h-milz/wireless-gk/doc/Filter-NE5532.png

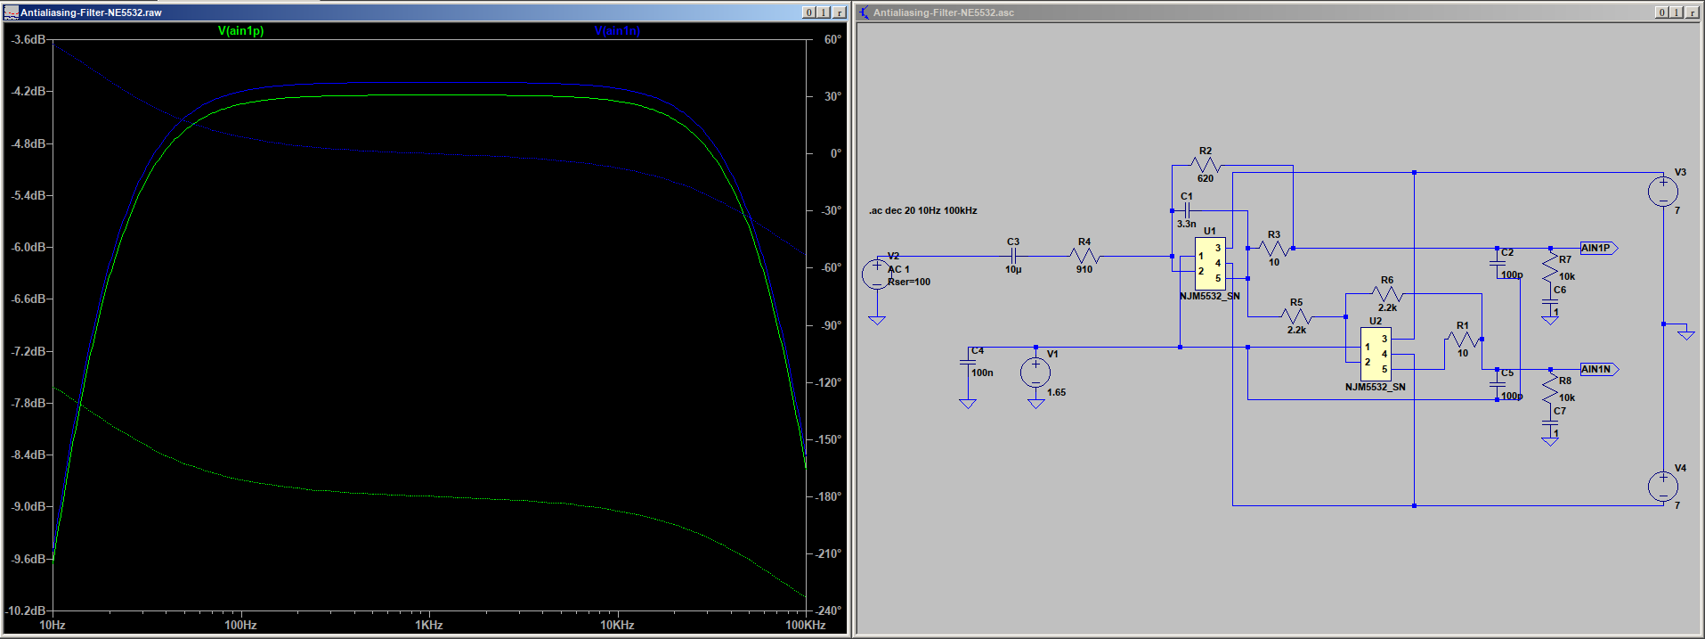
doc/Filter-NE5532.png
