h-milz/wireless-gk/doc/GK-3-schematics.png

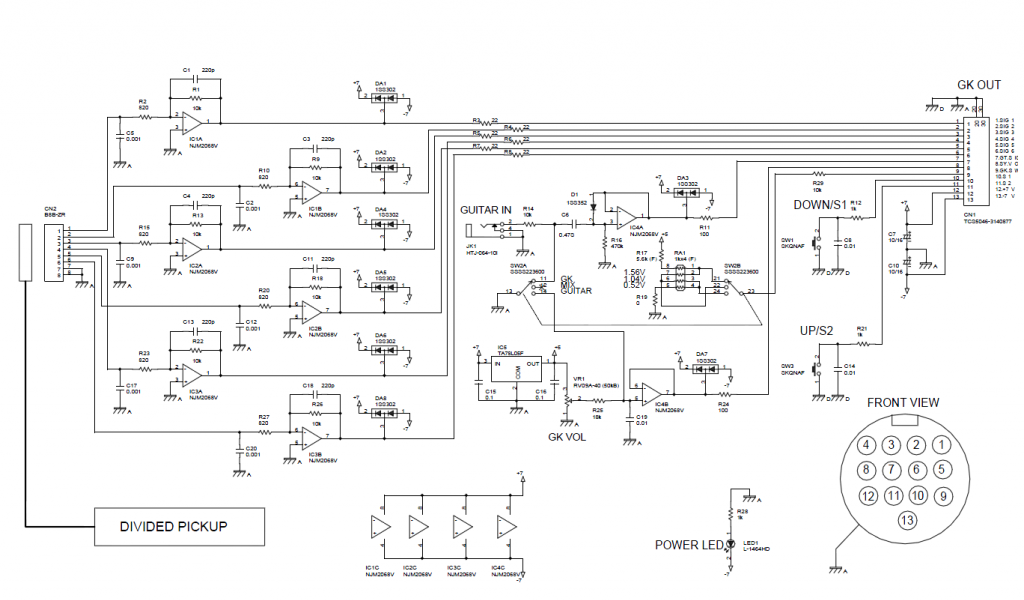
doc/GK-3-schematics.png
