h-milz/wireless-gk/main/main.c

/* 
    Copyright (C) 2024 Harald Milz <hm@seneca.muc.de> 

    This file is part of Wireless-GK.
    
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
    You should have received a copy of the GNU General Public License
    along with Wireless-GK.  If not, see <http://www.gnu.org/licenses/>.
*/

#include "wireless_gk.h"

#define ID_PIN                  GPIO_NUM_13             // take the one that is nearest to GND

static const char *TAG = "wgk_main";

EventGroupHandle_t s_wifi_event_group;

// static volatile uint32_t sample_count = 0; // , txcount = 0, rxcount = 0, losses = 0, loopcount = 0, overall_losses = 0, overall_packets = 0;

udp_buf_t *udp_tx_buf, *udp_rx_buf;

#if (defined RX_DEBUG || defined TX_DEBUG)
DRAM_ATTR volatile int p = 0; 
DRAM_ATTR volatile log_t _log[NUM];   
#endif 

// uint32_t time1; 

#ifdef WITH_TEMP
float rx_temp, tx_temp;
#endif


// Timer configuration
#include "driver/gptimer.h"

// Handle for the general-purpose timer
static gptimer_handle_t gptimer = NULL;

// Initialize the hardware timer
static void init_hardware_timer(void) {
    gptimer_config_t timer_config = {
        .clk_src = GPTIMER_CLK_SRC_DEFAULT, // Use default clock source
        .direction = GPTIMER_COUNT_UP,     // Count upwards
        .resolution_hz = 1000000,          // 1 MHz resolution (1 tick = 1 µs)
    };
    ESP_ERROR_CHECK(gptimer_new_timer(&timer_config, &gptimer));
    ESP_ERROR_CHECK(gptimer_enable(gptimer));
    ESP_ERROR_CHECK(gptimer_start(gptimer));
}

// ISR-safe function to read the timer value
uint32_t get_time_us_in_isr(void) {
    uint64_t timer_val = 0;
    ESP_ERROR_CHECK(gptimer_get_raw_count(gptimer, &timer_val));
    return (uint32_t) timer_val & 0xffffffff;
}


/*
 * WiFi stuff
 */

// mostly copied from examples/wifi/getting_started/station/main/station_example_main.c
/* FreeRTOS event group to signal when we are connected*/
static int s_retry_num = 0;



void monitor_task(void *args) {
    UBaseType_t hwm; 
    char *task_name; 
    bool *sender = (bool *) args;
    TaskHandle_t tasks[] = { i2s_rx_task_handle, udp_tx_task_handle, i2s_tx_task_handle, udp_rx_task_handle, NULL };
    while (1) {
        for (int i=0; i<sizeof(tasks)/sizeof(TaskHandle_t); i++) {
            hwm = uxTaskGetStackHighWaterMark(tasks[i]);
            task_name = pcTaskGetName(tasks[i]);
            ESP_LOGI (TAG, "task %s, HWM %d", task_name, hwm);
        }
        ESP_LOGI (TAG, "largest free block: %u", heap_caps_get_largest_free_block(MALLOC_CAP_8BIT));
        ESP_LOGI (TAG, "min free heap size: %lu", esp_get_minimum_free_heap_size());

        vTaskDelay (1000/portTICK_PERIOD_MS);
    }
}

#ifdef WITH_TEMP    
#include "driver/temperature_sensor.h"
void tx_temp_task(void *args) {
    temperature_sensor_handle_t temp_sensor = NULL;
    temperature_sensor_config_t temp_sensor_config = TEMPERATURE_SENSOR_CONFIG_DEFAULT(10, 80);

    temperature_sensor_install(&temp_sensor_config, &temp_sensor);
    ESP_LOGI(TAG, "Enable temperature sensor");
    temperature_sensor_enable(temp_sensor);

    while (1) {
        temperature_sensor_get_celsius(temp_sensor, &tx_temp);
        ESP_LOGI(TAG, "T = %.1f °C", tx_temp); 
        vTaskDelay (10000/portTICK_PERIOD_MS);  // once per minute
    }
}

void rx_temp_task(void *args) {
    temperature_sensor_handle_t temp_sensor = NULL;
    temperature_sensor_config_t temp_sensor_config = TEMPERATURE_SENSOR_CONFIG_DEFAULT(10, 80);

    temperature_sensor_install(&temp_sensor_config, &temp_sensor);
    ESP_LOGI(TAG, "Enable temperature sensor");
    temperature_sensor_enable(temp_sensor);

    while (1) {
        temperature_sensor_get_celsius(temp_sensor, &rx_temp);
        // ESP_LOGI(TAG, "T = %.1f °C", temperature); 
        vTaskDelay (10000/portTICK_PERIOD_MS);  // once per minute
    }
}
#endif


// calculate simple XOR checksum based on uint32_t, which is much faster than using uint8_t
// there are 4x less XOR operations
// and ESP32 does not support unaligned uint8_t accesses and will always generate an exception
uint32_t calculate_checksum(uint32_t *buffer, size_t size) {
    uint32_t checksum = 0;
    int i; 
    
    for (i = 0; i < size; i++) {  
        checksum ^= *(buffer + i);
    }
    return checksum; 
}



void app_main(void) {

    bool sender = false; 
    bool creds_available = false;
    bool setup_requested = false;
    int i; 
    
    //Initialize NVS
    esp_err_t ret = nvs_flash_init();
    if (ret == ESP_ERR_NVS_NO_FREE_PAGES || ret == ESP_ERR_NVS_NEW_VERSION_FOUND) {
      ESP_ERROR_CHECK(nvs_flash_erase());
      ret = nvs_flash_init();
      ESP_LOGW(TAG, "nvs erase, init"); 
    }
    ESP_ERROR_CHECK(ret);
    s_wifi_event_group = xEventGroupCreate();
    
    // check if we're sender or receiver. The sender has ID_PIN = 0
    gpio_reset_pin(ID_PIN);
    gpio_set_direction(ID_PIN, GPIO_MODE_INPUT);
    gpio_set_pull_mode(ID_PIN, GPIO_PULLUP_ONLY);
    gpio_pullup_en(ID_PIN);
    if (gpio_get_level(ID_PIN) == 0) {
        sender = true; 
    } 
    gpio_reset_pin(ID_PIN);

    init_hardware_timer();
    
    if (sender) {
        // initialize GPIO pins
        // returns true if setup was pressed
        setup_requested = init_gpio_tx();
        if (setup_requested) {   // setup needed
            ESP_ERROR_CHECK(nvs_flash_erase());
            nvs_flash_init();
            ESP_LOGI(TAG, "setup requested, entering setup mode");
        }
    
        // initialize Wifi STA
        init_wifi_tx(setup_requested);
        
        // let it settle. 
        vTaskDelay(200/portTICK_PERIOD_MS);

#ifdef WITH_TEMP    
        xTaskCreate(tx_temp_task, "tx_temp_task", 4096, NULL, 5, NULL);
#endif
        
        // create udp send buffer explicitly in RAM
        udp_tx_buf = (udp_buf_t *)heap_caps_calloc(1, sizeof(udp_buf_t), MALLOC_CAP_8BIT | MALLOC_CAP_INTERNAL);         
        
        // set up I2S receive channel on the Sender
        i2s_new_channel(&i2s_rx_chan_cfg, NULL, &i2s_rx_handle);
        // this will later be i2s_channel_init_tdm_mode(). 
#ifdef I2S_STD
        i2s_channel_init_std_mode(i2s_rx_handle, &i2s_rx_cfg);
#else
        i2s_channel_init_tdm_mode(i2s_rx_handle, &i2s_rx_cfg);
#endif        

// #ifdef LATENCY_MEAS            
        // xTaskCreate(latency_meas_task, "latency_meas_task", 4096, NULL, 5, NULL);
// #else        
        // create I2S Rx task
        // xTaskCreate(i2s_rx_task, "i2s_rx_task", 4096, NULL, 18, &i2s_rx_task_handle);

        // create UDP Tx task
        xTaskCreate(udp_tx_task, "udp_tx_task", 4096, NULL, 18, &udp_tx_task_handle);

        // xTaskCreate(monitor_task, "monitor_task", 4096, &sender, 3, NULL);

        // create I2S rx on_recv callback
        i2s_event_callbacks_t cbs = {
            .on_recv = i2s_rx_callback,
            .on_recv_q_ovf = NULL,
            .on_sent = NULL,
            .on_send_q_ovf = NULL,
        };
        i2s_channel_register_event_callback(i2s_rx_handle, &cbs, NULL);

        // enable channel
        i2s_channel_enable(i2s_rx_handle);
// #endif /* LATENCY_MEAS*/        
        // ESP_LOGI(TAG, "sizeof(udp_tx_buf) = %d", sizeof(udp_buf_t));
        
    } else {   // receiver
        // initialize GPIO pins
        // returns true if setup was pressed
        setup_requested = init_gpio_rx();
        if (setup_requested) {   // setup needed
            ESP_ERROR_CHECK(nvs_flash_erase());
            nvs_flash_init();
            ESP_LOGI(TAG, "setup requested, entering setup mode");
        }

        // TODO check if we had WiFi credentials in NVS, if not, setup. 
    
        // initialize Wifi AP
        init_wifi_rx(setup_requested);
        // let it settle. 
        vTaskDelay(200/portTICK_PERIOD_MS);
        
#ifdef WITH_TEMP    
        xTaskCreate(rx_temp_task, "rx_temp_task", 4096, NULL, 5, NULL);
#endif

        // initialize i2s ring buffer
        if (!ring_buf_init()) {              // This Should Not Happen[TM]
            vTaskDelete(NULL); 
        }
        // and the UDP receive buffer
        udp_rx_buf = (udp_buf_t *)heap_caps_calloc(1, sizeof(udp_buf_t), MALLOC_CAP_8BIT | MALLOC_CAP_INTERNAL); 
            
        // set up I2S send channel on the Receiver
        i2s_new_channel(&i2s_tx_chan_cfg, &i2s_tx_handle, NULL);
        // this will later be i2s_channel_init_tdm_mode(). 
#ifdef I2S_STD
        i2s_channel_init_std_mode(i2s_tx_handle, &i2s_tx_cfg);
#else
        i2s_channel_init_tdm_mode(i2s_tx_handle, &i2s_tx_cfg);
#endif               

        // create UDP Rx task
        xTaskCreate(udp_rx_task, "udp_rx_task", 4096, NULL, 18, &udp_rx_task_handle);
        
#ifdef RX_STATS
        xTaskCreate(rx_stats_task, "rx_stats_task", 4096, NULL, 5, NULL); 
#endif        

        // xTaskCreate(monitor_task, "monitor_task", 4096, NULL, 3, NULL);

        // create I2S tx on_sent callback
        i2s_event_callbacks_t cbs = {
            .on_recv = NULL,
            .on_recv_q_ovf = NULL,
            .on_sent = i2s_tx_callback,
            .on_send_q_ovf = NULL,
        };
        i2s_channel_register_event_callback(i2s_tx_handle, &cbs, NULL);

        i2s_channel_enable(i2s_tx_handle);
        // time1 = get_time_us_in_isr();
        // stats[0] = -1000;
        // stats[1] = 1000; 
        // ESP_LOGI(TAG, "sizeof(udp_rx_buf) = %d", sizeof(udp_buf_t));
        // ESP_LOGI(TAG, "sizeof(ringbuf)    = %d", ring_buf_size());
    }
    
    ESP_LOGI (TAG, "largest free block: %u", heap_caps_get_largest_free_block(MALLOC_CAP_8BIT));
    ESP_LOGI (TAG, "min free heap size: %lu", esp_get_minimum_free_heap_size());

/*    
    while (1) {
        vTaskDelay(1000/ portTICK_PERIOD_MS);
    }
*/    
}
