h-milz/wireless-gk/main/wireless_gk.h

/* 
    Copyright (C) 2024 Harald Milz <hm@seneca.muc.de> 

    This file is part of Wireless-GK.
    
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
    You should have received a copy of the GNU General Public License
    along with Wireless-GK.  If not, see <http://www.gnu.org/licenses/>.
*/

#ifndef _WIRELESS_GK_H
#define _WIRELESS_GK_H

#include <string.h>
#include <stdlib.h>
#include <stdio.h> 
#include <dirent.h> 
#include "freertos/FreeRTOS.h"
#include "freertos/event_groups.h"
#include "freertos/queue.h"
#include "freertos/task.h"
#include "esp_event.h"
#include "esp_heap_caps.h"
#include "esp_log.h"
#include "esp_netif.h"
#include "esp_random.h"
#include "esp_system.h"
#include "esp_timer.h"
#include "esp_wifi.h"
#include "esp_wps.h"
#include "nvs_flash.h"
#include "driver/gpio.h"
#include "rom/ets_sys.h"
#include "lwip/err.h"
#include <lwip/netdb.h>
#include "lwip/sockets.h"
#include "lwip/sys.h"
#include "lwip/errno.h"
// #include "ringbuf.h" 


// TODO remove for production compilation 
#pragma GCC diagnostic ignored "-Wunused-variable"
#pragma GCC diagnostic ignored "-Wunused-but-set-variable"


// #define TX_DEBUG
// #define RX_DEBUG
// #define LATENCY_MEAS                 // activate this if you want to do a UDP latency measurement. 
                                        // Connect Tx SIG_PIN to Rx ISR_PIN and GND to GND. 
#define WITH_TEMP

// during development, we use STD with PCM1808 ADC and PCM5102 DAC
#define I2S_STD
// #define I2S_TDM

#ifdef I2S_STD
#include "driver/i2s_std.h"
#else
#include "driver/i2s_tdm.h"
#endif

/* ***************************************************************
 * WiFi Defines
 * ***************************************************************/

#define TX_TEST

#ifdef TX_TEST
#define SSID "WGK"
#define PASS "start123"
#define WIFI_CHANNEL 144
#endif
#define RX_IP_ADDR "192.168.4.1"
#define PORT 45678

#define MAX_RETRY 5

#define WIFI_CONNECTED_BIT BIT0
#define WIFI_FAIL_BIT      BIT1

extern EventGroupHandle_t s_wifi_event_group;
void event_handler(void* arg, esp_event_base_t event_base, int32_t event_id, void* event_data);


/* ***************************************************************
 * Logging
 * ***************************************************************/

#if (defined RX_DEBUG || defined TX_DEBUG)
#define NUM 50
typedef struct { 
    uint8_t loc;        // location
    uint32_t time;      // timestamp in µs
    uint8_t *ptr;       // pointer to buffer
    uint32_t size;        // data size
    uint32_t uint32ptr;       // converted pointer to buffer
} log_t; 
extern volatile int p;
extern volatile log_t _log[];
#endif 

/* ***************************************************************
 * I2S Defines
 * ***************************************************************/

#define I2S_MCLK_MULTIPLE I2S_MCLK_MULTIPLE_256
#define I2S_DATA_BIT_WIDTH I2S_DATA_BIT_WIDTH_32BIT

/*
 * Definitions for I2S
 * SAMPLE  is a single sample for one channel (32 bit data block containing a 16, 24, or 32 bit ADC sample)
 * FRAME   is a collection of NUM_SLOTS slots (mono samples per channel)
 *         see MSB format in 
 *         https://docs.espressif.com/projects/esp-idf/en/latest/esp32c5/api-reference/peripherals/i2s.html#tdm-mode
 * NFRAMES is the number of frames we want to send in one datagram in order to minimize UDP protocol overhead.
 *         this is intended to fill one UDP payload so that no IP fragmentation takes place.
 *         The default MTU size for WiFi is 1500, resulting in a maximum payload of 1472 byte.
 *         We send NSAMPLES * NUM_SLOTS_UDP * SLOT_SIZE_UDP byte = 1440 byte. 61 frames would work as well. 
 */ 
#define NFRAMES                 60                      // the number of frames we want to send in a datagram 
#define NUM_SLOTS_I2S           2                       // number of channels in one sample, 2 for stereo, 8 for 8-channel audio
#define SLOT_SIZE_I2S           4                       // I2S has slots with 4 byte each. The data type is int. 
#define NUM_SLOTS_UDP           8                       // we always send 8 slot frames
#define SLOT_SIZE_UDP           3                       // UDP format has 3-byte samples.
#define SLOT_BIT_WIDTH          SLOT_SIZE_I2S * 8       // bits per slot
#define NUM_RX_DMA_BUFS         4                       // Number of DMA buffers in the sender.  RX is here I2S RX
#define NUM_TX_DMA_BUFS         2                       // the receiver only uses 2. TX is here I2S TX

#define I2S_BUF_SIZE            NFRAMES * NUM_SLOTS_I2S * SLOT_SIZE_I2S  // Size of each I2S or DMA buffer

#define UDP_BUF_SIZE            NFRAMES * NUM_SLOTS_UDP * SLOT_SIZE_UDP
#define NUM_RINGBUF_ELEMS       256                      // this needs to be a power of 2. 
// #define UDP_PAYLOAD_SIZE        UDP_BUF_SIZE + 16       // 
#define RINGBUF_OFFSET          3                       // when do we start to shuffle data to I2S. 

#define NUM_I2S_BUFS            4 
// #define I2S_CBUF_SIZE           I2S_BUF_SIZE * NUM_I2S_BUFS  // ring buffer size 

#define I2S_NUM                 I2S_NUM_AUTO
#define SAMPLE_RATE             31250                   // 48000 should work as well, or anything less


/* ***************************************************************
 * I2S Rx config for the sender
 * ***************************************************************/

static i2s_chan_config_t i2s_rx_chan_cfg = {
    .id = I2S_NUM_AUTO,
    .role = I2S_ROLE_MASTER,
    .dma_desc_num = NUM_TX_DMA_BUFS,
    .dma_frame_num = NFRAMES, 
    .auto_clear_after_cb = false, 
    .auto_clear_before_cb = false, 
    .allow_pd = false, 
    .intr_priority = 5, 
};    

#ifdef I2S_STD
static i2s_std_config_t i2s_rx_cfg = {
#else
static i2s_tdm_config_t i2s_rx_cfg = {
#endif
    .clk_cfg = {                                // I2S_STD_CLK_DEFAULT_CONFIG(SAMPLE_RATE),
        .sample_rate_hz = SAMPLE_RATE,
        .mclk_multiple = I2S_MCLK_MULTIPLE,     // Set MCLK / WS ratio 
        .clk_src = I2S_CLK_SRC_XTAL, // DEFAULT,    // I2S_CLK_SRC_DEFAULT,         // we will use I2S_CLK_SRC_EXTERNAL !
        // .ext_clk_freq_hz = 11289600,         // if external. sample_rate_hz * slot_bits * slot_num
    },
#ifdef I2S_STD
    .slot_cfg = I2S_STD_MSB_SLOT_DEFAULT_CONFIG(I2S_DATA_BIT_WIDTH, I2S_SLOT_MODE_STEREO),
#else
    .slot_cfg = I2S_TDM_MSB_SLOT_DEFAULT_CONFIG(I2S_DATA_BIT_WIDTH, I2S_SLOT_MODE_STEREO,
                                  I2S_TDM_SLOT0 | I2S_TDM_SLOT1 ), // | I2S_TDM_SLOT2 | I2S_TDM_SLOT3 ), 
//                              | I2S_TDM_SLOT4 | I2S_TDM_SLOT5 | I2S_TDM_SLOT6 | I2S_TDM_SLOT7 ),
#endif
    .gpio_cfg = {
        .mclk = GPIO_NUM_2,                    // pick the pins that are closest to the ADC without crossing PCB traces. 
        .bclk = GPIO_NUM_3,
        .ws = GPIO_NUM_4,
        .dout = I2S_GPIO_UNUSED,
        .din = GPIO_NUM_5,
        .invert_flags = {
            .mclk_inv = false,
            .bclk_inv = false,
            .ws_inv = true,                     // we use AK5538 mode 32/36 (start on rising WS edge)
        },
    },
};

/* ***************************************************************
 * I2S Tx Config for the Receiver
 * ***************************************************************/

static i2s_chan_config_t i2s_tx_chan_cfg = {
    .id = I2S_NUM_AUTO,
    .role = I2S_ROLE_MASTER,
    .dma_desc_num = NUM_TX_DMA_BUFS, 
    .dma_frame_num = NFRAMES, 
    .auto_clear_after_cb = false,     // we don't need to do that ourselves. 
    .auto_clear_before_cb = false, 
    .allow_pd = false, 
    .intr_priority = 5, 
};    

#ifdef I2S_STD   
static i2s_std_config_t i2s_tx_cfg = {
#else
static i2s_tdm_config_t i2s_tx_cfg = {
#endif
    .clk_cfg = {                                // I2S_STD_CLK_DEFAULT_CONFIG(SAMPLE_RATE),
        .sample_rate_hz = SAMPLE_RATE,
        .mclk_multiple = I2S_MCLK_MULTIPLE,     // Set MCLK / WS ratio
        .clk_src = I2S_CLK_SRC_XTAL, // DEFAULT, // ,         // we will use I2S_CLK_SRC_EXTERNAL !
        // .ext_clk_freq_hz = 11289600,         // if external. sample_rate_hz * slot_bits * slot_num
    },
#ifdef I2S_STD
    .slot_cfg = I2S_STD_MSB_SLOT_DEFAULT_CONFIG(I2S_DATA_BIT_WIDTH, I2S_SLOT_MODE_STEREO),
#else
    .slot_cfg = I2S_TDM_MSB_SLOT_DEFAULT_CONFIG(I2S_DATA_BIT_WIDTH, I2S_SLOT_MODE_STEREO,
                                  I2S_TDM_SLOT0 | I2S_TDM_SLOT1 | I2S_TDM_SLOT2 | I2S_TDM_SLOT3 ), 
//                              | I2S_TDM_SLOT4 | I2S_TDM_SLOT5 | I2S_TDM_SLOT6 | I2S_TDM_SLOT7 ),
#endif
    .gpio_cfg = {
        .mclk = GPIO_NUM_2,                    // pick the pins that are closest to the DAC without crossing PCB traces. 
        .bclk = GPIO_NUM_3,
        .ws = GPIO_NUM_4,
        .dout = GPIO_NUM_5,
        .din = I2S_GPIO_UNUSED,
        .invert_flags = {
            .mclk_inv = false,
            .bclk_inv = false,
            .ws_inv = true,                     // we use AK4438 mode 14/18 (start on rising WS edge)
        },
    },
};

/* ***************************************************************
 * buffer stuff 
 * ***************************************************************/
 
typedef struct {
    int slot[NUM_SLOTS_I2S];
} i2s_frame_t;

typedef struct {
    i2s_frame_t frame[NFRAMES];
} i2s_buf_t;     


typedef struct {
    uint8_t slot[NUM_SLOTS_UDP * SLOT_SIZE_UDP];
} udp_frame_t;

// #define WITH_TIMESTAMP

typedef struct {
    udp_frame_t frame[NFRAMES];
    uint32_t checksum;
    uint32_t sequence_number;
#ifdef WITH_TIMESTAMP    
    uint32_t timestamp; 
#endif    
#ifdef WITH_TEMP
    float tx_temp;
#endif    
    uint32_t switches;
} udp_buf_t;

bool ring_buf_init(void);
size_t ring_buf_size(void); 
void ring_buf_put(udp_buf_t *udp_buf); 
uint8_t *ring_buf_get(void);

// TODO: these can be privatized too. 
extern udp_buf_t *udp_tx_buf, *udp_rx_buf;


/* 
 * RX stats
 * 0 maxdiff
 * 1 mindiff
 * 2 num ssn<=rsn
 */
  
#define RX_STATS 
#ifdef RX_STATS 
#define NUM_STATS 5
extern int stats[NUM_STATS];  
#endif
// #define SSN_STATS
// #define SSN_TRACE

/* ***************************************************************
 * Function prototypes
 * ***************************************************************/

// Sender stuff
extern i2s_chan_handle_t i2s_rx_handle;
extern TaskHandle_t i2s_rx_task_handle; 
extern TaskHandle_t udp_tx_task_handle; 
void init_wifi_tx(bool setup_needed);
void udp_tx_task(void *args);
bool i2s_rx_callback(i2s_chan_handle_t handle, i2s_event_data_t *event, void *user_ctx); 
void i2s_rx_task(void *args);
bool init_gpio_tx(void);
void tx_setup (void);
void latency_meas_task(void *args); 
void tx_temp_task(void *args); 

// Receiver stuff
extern i2s_chan_handle_t i2s_tx_handle;
extern TaskHandle_t i2s_tx_task_handle; 
extern TaskHandle_t udp_rx_task_handle; 
void init_wifi_rx(bool setup_needed);
void udp_rx_task(void *args);
bool i2s_tx_callback(i2s_chan_handle_t handle, i2s_event_data_t *event, void *user_ctx); 
void i2s_tx_task(void *args);
bool init_gpio_rx(void);
int find_free_channel(void);
void rx_stats_task(void *args);
void rx_temp_task(void *args); 
extern uint32_t time3; 

#ifdef WITH_TEMP
extern float rx_temp, tx_temp; 
#endif

// main stuff
typedef struct { 
    uint8_t *dma_buf;       // pointer to buffer
    uint32_t size;        // data size
} dma_params_t; 


uint32_t get_time_us_in_isr(void);
uint32_t calculate_checksum(uint32_t *buffer, size_t size); 

#define NEOPIX_PIN GPIO_NUM_27              // for the DevKit-C
#ifndef MIN
#define MIN(a,b) ((a)<(b)?(a):(b))
#endif




#endif /* _WIRELESS_GK_H */
