h-milz/wireless-gk/main/wgk_receiver.c

/* 
    Copyright (C) 2024 Harald Milz <hm@seneca.muc.de> 

    This file is part of Wireless-GK.

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
    You should have received a copy of the GNU General Public License
    along with Wireless-GK.  If not, see <http://www.gnu.org/licenses/>.
*/

#include "wireless_gk.h"

#define LED_PIN                 GPIO_NUM_10             // 
#define SETUP_PIN               GPIO_NUM_14             // take the one that is nearest to the push button
#define SIG_PIN                 GPIO_NUM_8
#define ISR_PIN                 GPIO_NUM_9


static const char *RX_TAG = "wgk_rx";

DRAM_ATTR volatile uint32_t start_time = 0;
static uint32_t stop_time = 0, diff_time = 0;

i2s_chan_handle_t i2s_tx_handle = NULL;
TaskHandle_t i2s_tx_task_handle = NULL; 
TaskHandle_t udp_rx_task_handle = NULL; 

static esp_wps_config_t wps_config = WPS_CONFIG_INIT_DEFAULT(WPS_TYPE_PBC);

#ifdef RX_DEBUG
static char t[][20] = {"ISR", "begin i2s_tx loop", "after notify", "unpacking", "before recvfrom", "after recvfrom", "end i2s_tx loop" }; 
#endif

#ifdef RX_STATS
int stats[NUM_STATS];  
#endif     

static void wifi_event_handler(void* arg, esp_event_base_t event_base,
		int32_t event_id, void* event_data)
{
	switch (event_id) {
	case WIFI_EVENT_AP_START:
		ESP_LOGI(RX_TAG, "WIFI_EVENT_AP_START");
		break;
	case WIFI_EVENT_AP_STADISCONNECTED:
		{
			ESP_LOGI(RX_TAG, "WIFI_EVENT_AP_STADISCONNECTED");
			wifi_event_ap_stadisconnected_t* event = (wifi_event_ap_stadisconnected_t*) event_data;
			ESP_LOGI(RX_TAG, "station "MACSTR" leave, AID=%d, reason=%d",
					MAC2STR(event->mac), event->aid, event->reason);
		}
		break;
	case WIFI_EVENT_AP_STACONNECTED:
		{
			ESP_LOGI(RX_TAG, "WIFI_EVENT_AP_STACONNECTED");
			wifi_event_ap_staconnected_t* event = (wifi_event_ap_staconnected_t*) event_data;
			ESP_LOGI(RX_TAG, "station "MACSTR" join, AID=%d",
					MAC2STR(event->mac), event->aid);
		}
		break;
	case WIFI_EVENT_AP_WPS_RG_SUCCESS:
		{
			ESP_LOGI(RX_TAG, "WIFI_EVENT_AP_WPS_RG_SUCCESS");
			wifi_event_ap_wps_rg_success_t *evt = (wifi_event_ap_wps_rg_success_t *)event_data;
			ESP_LOGI(RX_TAG, "station "MACSTR" WPS successful",
					MAC2STR(evt->peer_macaddr));
		}
		break;
	case WIFI_EVENT_AP_WPS_RG_FAILED:
		{
			ESP_LOGI(RX_TAG, "WIFI_EVENT_AP_WPS_RG_FAILED");
			wifi_event_ap_wps_rg_fail_reason_t *evt = (wifi_event_ap_wps_rg_fail_reason_t *)event_data;
			ESP_LOGI(RX_TAG, "station "MACSTR" WPS failed, reason=%d",
						MAC2STR(evt->peer_macaddr), evt->reason);
			ESP_ERROR_CHECK(esp_wifi_ap_wps_disable());
			ESP_ERROR_CHECK(esp_wifi_ap_wps_enable(&wps_config));
			ESP_ERROR_CHECK(esp_wifi_ap_wps_start(NULL));
		}
		break;
	case WIFI_EVENT_AP_WPS_RG_TIMEOUT:
		{
			ESP_LOGI(RX_TAG, "WIFI_EVENT_AP_WPS_RG_TIMEOUT");
			ESP_ERROR_CHECK(esp_wifi_ap_wps_disable());
			ESP_ERROR_CHECK(esp_wifi_ap_wps_enable(&wps_config));
			ESP_ERROR_CHECK(esp_wifi_ap_wps_start(NULL));
		}
		break;
	default:
		break;
	}
}

/*
 * scan the network for the best free channel
 */ 

#define MAX_AP_RECORDS 20
#define CHAN_MAX 177
// https://en.wikipedia.org/wiki/List_of_WLAN_channels
static int channels[] = { 36, 40, 44, 48, 52, 56, 60, 64, 68, 96, 100, 104, 
                          108, 112, 116, 120, 124, 128, 132, 136, 140, 144, 
                          149, 153, 157, 161, 165, 169, 173, 177 }; 
static int channel_usage[CHAN_MAX+1] = {0};  // For 5GHz use 
static wifi_ap_record_t ap_records[MAX_AP_RECORDS];

// TODO as soon as ESP-IDF supports country settings for 5G, use them, 
// preferably a safe mode that works internationally
// very possible that wifi_scan_config_t will be set correctly anyway. 
// in MCS7, the transmit power is internally set to 13 dBm for HT20 which is equivalent to ~20 mW. 
int find_free_channel(void) {
    // country settings? 
    
    wifi_scan_config_t scan_config = {
        .ssid = NULL,
        .bssid = NULL,
        .channel = 0,      // Scan all channels
        .show_hidden = false,
        .scan_type = WIFI_SCAN_TYPE_PASSIVE,
    };

    // blink "channel scan"
    ESP_LOGI(RX_TAG, "performing channel scan");
    esp_netif_create_default_wifi_sta();

    wifi_init_config_t cfg = WIFI_INIT_CONFIG_DEFAULT();
    ESP_ERROR_CHECK(esp_wifi_init(&cfg));
    ESP_ERROR_CHECK(esp_wifi_set_mode(WIFI_MODE_STA));
    ESP_ERROR_CHECK(esp_wifi_start());
    ESP_ERROR_CHECK(esp_wifi_set_band_mode(WIFI_BAND_MODE_5G_ONLY));
    ESP_ERROR_CHECK(esp_wifi_scan_start(&scan_config, true));

    uint16_t ap_count = 0;
    ESP_ERROR_CHECK(esp_wifi_scan_get_ap_num(&ap_count));
    ESP_LOGI(RX_TAG, "Found %d access points", ap_count);

    if (ap_count > MAX_AP_RECORDS) {
        ap_count = MAX_AP_RECORDS;
    }

    ESP_ERROR_CHECK(esp_wifi_scan_get_ap_records(&ap_count, ap_records));

    // Analyze channel usage
    for (int i = 0; i < ap_count; i++) {
        ESP_LOGI(RX_TAG, "SSID: %s, Channel: %d, RSSI: %d", ap_records[i].ssid, ap_records[i].primary, ap_records[i].rssi);
        channel_usage[ap_records[i].primary]++;
    }

    // Select the channel with the least congestion (least number of APs) 
    int best_channel = 0;
    int min_usage = INT_MAX;
    for (int i = 0; i < sizeof(channels)/sizeof(int); i++) {
        if (channel_usage[channels[i]] < min_usage) {
            best_channel = channels[i];
            min_usage = channel_usage[channels[i]];
        }
    }

    ESP_LOGI(RX_TAG, "Best channel: %d with usage count: %d", best_channel, min_usage);
    // esp_wifi_set_mode(WIFI_MODE_NULL); 
    ESP_ERROR_CHECK(esp_wifi_stop());
    esp_netif_destroy_default_wifi(WIFI_IF_STA);
    return (best_channel); 
}


#define MAXLEN 32

void init_wifi_rx(bool setup_requested) {
    // we are WiFi AP 

    char ssid[MAXLEN];
    char pass[MAXLEN];

    ESP_ERROR_CHECK(esp_netif_init());
    ESP_ERROR_CHECK(esp_event_loop_create_default());

#ifdef TX_TEST
    int channel = WIFI_CHANNEL;
#else    
    int channel = find_free_channel(); 
#endif    
    ESP_LOGI(RX_TAG, "using free channel %d", channel);
    
    esp_netif_create_default_wifi_ap();

    wifi_init_config_t cfg = WIFI_INIT_CONFIG_DEFAULT();
    ESP_ERROR_CHECK(esp_wifi_init(&cfg));
    
    wifi_config_t wifi_config; 
    int ret = esp_wifi_get_config(WIFI_IF_AP, &wifi_config);
    ESP_LOGI (RX_TAG, "esp_wifi_get_config found ssid %s", (char *)wifi_config.ap.ssid);
    ESP_LOGI (RX_TAG, "esp_wifi_get_config found pass %s", (char *)wifi_config.ap.password);
#ifdef TX_TEST
    if (true) {
#else        
    if (wifi_config.ap.ssid[0] == '\0' || ! strncmp ((char *)wifi_config.ap.ssid, "ESP_", 4)) {
#endif    
        // cfg is invalid.
#ifndef TX_TEST
        if (! setup_requested) {
            // we want the user to make an informed decision and not start WPS without consent
            ESP_LOGE(RX_TAG, "no valid WiFi credentials found - press setup!");
            // TODO blink "request setup"
            vTaskDelete(NULL);
        }
        ESP_LOGW(RX_TAG, "setup requested - creating new WiFi credentials");
#endif        
        memset(&wifi_config, 0, sizeof(wifi_config)); // Clear structure
#ifdef TX_TEST
        strncpy((char*)wifi_config.ap.ssid, SSID, sizeof(wifi_config.ap.ssid));
        strncpy((char*)wifi_config.ap.password, PASS, sizeof(wifi_config.ap.password));
        wifi_config.ap.ssid_len = strlen(SSID);
#else        
        // create random credentials.
        // TODO create SSID from SHA256 value
        snprintf (ssid, MAXLEN, "AP_%08lX%08lX%c", esp_random(), esp_random(), '\0');
        snprintf (pass, MAXLEN, "%08lX%08lX%c", esp_random(), esp_random(), '\0');
        ESP_LOGI(RX_TAG, "generated random ssid %s len %d pass %s", ssid, strlen(ssid), pass);
        strncpy((char*)wifi_config.ap.ssid, ssid, sizeof(wifi_config.ap.ssid));
        strncpy((char*)wifi_config.ap.password, pass, sizeof(wifi_config.ap.password));
        wifi_config.ap.ssid_len = strlen(ssid);
#endif
        wifi_config.ap.channel = channel;
        wifi_config.ap.max_connection = 2;          // TODO for debugging maybe, should be 1 in production
        wifi_config.ap.authmode = WIFI_AUTH_WPA3_PSK;
        wifi_config.ap.pmf_cfg.required = true;
    }    
    
    ESP_ERROR_CHECK(esp_event_handler_register(WIFI_EVENT, ESP_EVENT_ANY_ID, &wifi_event_handler, NULL));

    wifi_protocols_t proto_config = {0, };
    proto_config.ghz_2g = 0;
    proto_config.ghz_5g = WIFI_PROTOCOL_11AX;                    // we want 5 GHz 11AX WPA3. 

    ESP_ERROR_CHECK(esp_wifi_set_mode(WIFI_MODE_AP)); 
    ESP_ERROR_CHECK(esp_wifi_set_config(WIFI_IF_AP, &wifi_config));    

    ESP_ERROR_CHECK(esp_wifi_start());
    ESP_ERROR_CHECK(esp_wifi_set_band_mode(WIFI_BAND_MODE_5G_ONLY));
    ESP_ERROR_CHECK(esp_wifi_set_protocols(WIFI_IF_AP, &proto_config));            
    esp_wifi_set_ps(WIFI_PS_NONE);    // prevent  ENOMEM?             
    
    if (setup_requested) {
    	ESP_ERROR_CHECK(esp_wifi_ap_wps_enable(&wps_config));
  		ESP_ERROR_CHECK(esp_wifi_ap_wps_start(NULL));
  		ESP_LOGI(RX_TAG, "setup requested, enering wps ap registrar mode");
    }

    ESP_LOGI(RX_TAG, "wifi_init_softap finished. SSID:%s password:%s channel:%d",
             wifi_config.ap.ssid, wifi_config.ap.password, channel);

}


// on_sent callback, used to determine the pointer to the most recently emptied dma buffer
IRAM_ATTR bool i2s_tx_callback(i2s_chan_handle_t handle, i2s_event_data_t *event, void *user_ctx) {
    uint8_t *i2sbuf, *dmabuf;
    size_t size;


        
    dmabuf = (uint8_t *)event->dma_buf;
    size = event->size;

#ifdef RX_DEBUG
    _log[p].loc = 0;
    _log[p].time = get_time_us_in_isr();
    _log[p].ptr = event->dma_buf;
    _log[p].size = event->size; 
    p++;
#endif

    // fetch current ringbuf entry
    i2sbuf = ring_buf_get(); 
    if (i2sbuf == NULL) {           // this is the case when filling the buffer on system start 
                                    // or when recovering from a buffer overrun
        memset(dmabuf, 0, size);    // silence
    } else {                        // write data to most recently free'd DMA buffer
        memcpy(dmabuf, i2sbuf, size); 
    }        
    return false; 
}    

#ifdef LATENCY_MEAS
#include <math.h>
#endif

// udp_rx_task receives packets as they arrive, and puts them in the ring buffer
#define PACKETS_PER_SECOND (SAMPLE_RATE / NFRAMES)
void udp_rx_task(void *args) {

    int i, j;
    uint32_t count_received = 0, count_processed = 0; 
    uint32_t checksum, mychecksum; 
#ifdef LATENCY_MEAS    
    uint32_t count = 0; 
    uint32_t diff, avgdiff, sumdiff = 0; 
    float delta, M = 0.0, S = 0.0, variance, stddev; 
    uint32_t mindiff = 0xffffffff;
    uint32_t maxdiff = 0;
#endif    
    uint32_t numpackets = 0x07ff; 
    // uint32_t initial_count = 0;
    // uint32_t min_count = NUM_RINGBUF_ELEMS + RINGBUF_OFFSET;  

    struct sockaddr_storage source_addr;
    socklen_t socklen = sizeof(source_addr);
    struct sockaddr_in dest_addr;
    struct timeval timeout;
    
    dest_addr.sin_addr.s_addr = inet_addr(RX_IP_ADDR); 
    dest_addr.sin_family = AF_INET;
    dest_addr.sin_port = htons(PORT);

    timeout.tv_sec = 10;       // 1 second timeout is plenty! 
    timeout.tv_usec = 0;

    while (1) {

        int sock = socket(AF_INET, SOCK_DGRAM, IPPROTO_IP);
        if (sock < 0) {
            ESP_LOGE(RX_TAG, "Unable to create socket: errno %d", errno);
            break;           // just try again. 
        }

        // Set timeout
        setsockopt (sock, SOL_SOCKET, SO_RCVTIMEO, &timeout, sizeof(timeout));
        
        int err = bind(sock, (struct sockaddr *)&dest_addr, sizeof(dest_addr));
        if (err < 0) {
            ESP_LOGE(RX_TAG, "Socket unable to bind: errno %d", errno);
            // blink socket error
            vTaskDelete(NULL); 
        }
        ESP_LOGI(RX_TAG, "Socket bound, port %d", PORT);

        while(1) {

#ifdef RX_DEBUG        
            _log[p].loc = 4;
            _log[p].time = get_time_us_in_isr(); 
            p++;
#endif
            int len = recvfrom(sock, udp_rx_buf, sizeof(udp_buf_t), 0, NULL, NULL); // (struct sockaddr *)&source_addr, &socklen);

#ifdef RX_STATS
            // stats[0]++;
#endif
            
#ifdef LATENCY_MEAS
            stop_time = get_time_us_in_isr();
            // ESP_LOGI (RX_TAG, "latency: %lu µs", stop_time - start_time);
            diff = stop_time - start_time;
            mindiff = diff < mindiff ? diff : mindiff;
            maxdiff = diff > maxdiff ? diff : maxdiff; 
            sumdiff += diff;
            // using Welford’s algorithm. 
            count++; 
    	    delta = (float)diff - M;
    	    M = M + delta / count; 
    	    S = S + delta * ((float)diff - M); 
#endif

#if 0
    	    count_received = (count_received + 1) & numpackets; // 4096
    	    if (count_received == 0) {
    	        ESP_LOGI(RX_TAG, "%lu packets received, last len = %d ", numpackets+1, len); 
    	    }
#endif

#ifdef RX_DEBUG        
            _log[p].loc = 5;
            _log[p].time = get_time_us_in_isr(); 
            _log[p].size = (uint32_t)len; 
            p++;
#endif

            if (len == sizeof(udp_buf_t)) {
                // ESP_LOGW(RX_TAG, "len ok");
                // assume success. verify checksum 
                // checksum = udp_rx_buf->checksum; 
                // memcpy (&checksum, udp_rx_buf + UDP_BUF_SIZE, sizeof(checksum)); 
                // mychecksum = calculate_checksum((uint32_t *)udp_rx_buf, NFRAMES * sizeof(udp_frame_t) / 4); 
                // if (checksum == mychecksum) {
                    // ESP_LOGW(RX_TAG, "checksum ok");
                    ring_buf_put(udp_rx_buf);
#if 0
            	    count_processed = (count_processed + 1) & numpackets;
            	    if (count_processed == 0) {               // hier müsste man einen extra counter machen.
            	        ESP_LOGI(RX_TAG, "%lu packets processed", numpackets+1); 
#ifdef LATENCY_MEAS
            	        variance = S / (count - 1);
            	        stddev = sqrt(variance);
            	        printf ("min %lu, max %lu, avg' = %lu, avg %.2f, stddev %.2f\n", mindiff, maxdiff, sumdiff / count, M, stddev);  
            	        M = S = 0.0; 
            	        count = sumdiff = 0; 
            	        mindiff = 0xffffffff;
            	        maxdiff = 0; 
#endif            	        
            	    }
#endif 
                
                // TODO extract S1, S2 to global var. 
                // S1 S2 will be at (uint32_t)UDP_PAYLOAD_SIZE-1 , i.e. the last byte

                
                
#ifdef COUNT_PACKAGES
                mycount = (mycount + 1) & 0x00FFFFFF;   // 24 bit only
                // display once a second
                if (mycount % PACKETS_PER_SECOND == 0) {
                    memcpy (&count, 
                            (uint32_t *)(last_udp_buf + UDP_BUF_SIZE - 3),
                            3);
                    ESP_LOGI(RX_TAG, "count %lu, my_count %lu, diff %d", count, mycount, (int)count - (int)mycount); 
                }
#endif                
            } else if (len < 0) {
                // we ignore broken packets for now. 
#ifdef RX_STATS
                stats[7]++;
#endif
                ESP_LOGW(RX_TAG, "UDP receive error: %d", errno);
                continue; 
            }
            
#ifdef RX_DEBUG        
            _log[p].loc = 4;
            _log[p].time = get_time_us_in_isr(); 
            p++;
#endif
        }    
    }
}


#ifdef LATENCY_MEAS
// latency measurement
static void IRAM_ATTR handle_interrupt(void *args) {
    start_time = get_time_us_in_isr();
}
#endif


bool init_gpio_rx (void) {
    bool setup_needed = false; 
    
    // check if SETUP is pressed and then enter setup mode.  
    gpio_reset_pin(SETUP_PIN);
    gpio_set_direction(SETUP_PIN, GPIO_MODE_INPUT);
    gpio_set_pull_mode(SETUP_PIN, GPIO_PULLUP_ONLY);
    gpio_pullup_en(SETUP_PIN);
    if (gpio_get_level(SETUP_PIN) == 0) {
        setup_needed = true; 
    } 
    gpio_reset_pin(SETUP_PIN);

    // TODO Pins for S1 and S2
    // can be different for Rx and Tx depending on the PCB layout. 
    // can we read/write these using the ULP in the background every, say, 10 ms? 
            
    // LED to display function. 
    gpio_reset_pin(LED_PIN);
    gpio_set_direction(LED_PIN, GPIO_MODE_OUTPUT);
    gpio_pullup_dis(LED_PIN);
    gpio_set_intr_type(LED_PIN, GPIO_INTR_DISABLE);
    gpio_set_level(LED_PIN, 0);

#ifdef LATENCY_MEAS
    // enable the interrupt on ISR_PIN
    gpio_reset_pin(ISR_PIN); 
    gpio_set_direction(ISR_PIN, GPIO_MODE_INPUT);
    gpio_set_pull_mode(ISR_PIN, GPIO_PULLUP_ONLY);
    gpio_pullup_en(ISR_PIN);
    gpio_set_intr_type(ISR_PIN, GPIO_INTR_POSEDGE);
    // gpio_isr_register(handle_interrupt, NULL, ESP_INTR_FLAG_LEVEL3 | ESP_INTR_FLAG_IRAM, NULL); 
    gpio_install_isr_service(0);
    gpio_isr_handler_add(ISR_PIN, handle_interrupt, NULL);
    gpio_intr_enable(ISR_PIN);
#endif

    // Returns true if setup was pressed
    return (setup_needed); 
}
