h-milz/wireless-gk/(commit log)

2024-05-06 adding biphase-mark over cable
2024-05-15 added filter design link; some cleanups
2024-12-27 some ESP32-C5 and sample rate updates
2024-12-27 some ESP32-C5 and protoype building updates
2024-12-27 ESP32-C5 delivery update
2024-12-29 cable / socket option
2024-12-31 interrupt testing
2025-01-03 working Rx prototype (still w/o ADC)
2025-01-04 working sender prototype
2025-01-04 changed slot layout
2025-01-05 current measurement
2025-01-07 ESP32C5 adaptations and progress
2025-01-07 ESP32C5 changes
2025-01-09 updated frame packing algorithm
2025-01-09 AP works, first packets flowing
2025-01-13 sample rate and clock generation rewrite
2025-01-13 minor changes reflection current status
2025-01-13 development stage paragraph
2025-01-13 testing various sample formats
2025-01-20 testing sample interpolation
2025-01-22 2 DMA bufs only, double buffering
2025-01-22 removed i2s_rx_task, fixed checksum
    [main.c]
2025-01-22 removed i2s_rx_task, fixed callback
    [wgk_sender.c]
2025-01-22 modified i2s_tx_callback, final remove i2s_tx_task, fixed cbuf handling
    [wgk_receiver.c]
2025-01-23 added extra space for checksum and switches to the UDP Rx and Tx buffers, omitted i2s_rx_task, renamed buffers for clarity
2025-01-23 wifi: added pmf; fixed ring buffer init, lots of debug code
    [wgk_receiver.c]
2025-01-23 added extra space for checksum and switches to the UDP Rx and Tx buffers, renamed buffers for clarity
2025-01-24 various fixes, works now
    [main.c, wgk_receiver.c, wgk_sender.c, wireless_gk.h]
2025-01-25 frame packet interpolation test
2025-01-25 first changes for jitter buffering and interpolation
    [main.c, wgk_receiver.c, wgk_sender.c, wireless_gk.h]
2025-01-26 various inter-frame interpolation simulations
2025-01-27 more logging, don't init buf seqno and switches
2025-01-27 i2s_tx_callback: - removed unpacking - empty buffer handling - memcpy writes directly to DMA buffer
    udp_rx_callback:
    - new ringbuf changes
2025-01-27 main/wireless_gk.h: set NUM_RINGBUF_ELEMS to 8: much better
2025-01-27 main/wireless_gk.h: cleanup
2025-01-27 main/ringbuf.c: added case decisions
2025-01-27 main/ringbuf.c: small fix in case #1
    [ringbuf.c]
2025-01-27 main/ringbuf.c: address calculation fix in smoothe()
    [ringbuf.c]
2025-01-27 main/wgk_sender.c: tried to mitigate network not connected, doesn't work
    [wgk_sender.c]
2025-01-31 main/wgk_sender.c: start seeuqnce_number at 1 to avoid problems with 0
    [wgk_sender.c]
2025-02-02 main/ringbuf.c: adding stats vars and funcs, duplicate(), new case decisions, _get based on rsn
2025-02-02 main/wireless_gk.h: adding stats
2025-02-02 main/ringbuf.c: various fixes; stats logging
    [ringbuf.c]
2025-02-02 main/wgk_receiver.c: some fixes; stats logging
    [wgk_receiver.c]
2025-02-02 main/wireless_gk.h: offset = 3; stats logging
2025-02-02 doc/Components.md: added alternative sample rates
2025-02-02 README.md: some fixes; Current Status section
2025-02-03 main/ringbuf.c: reduced logging to avoid pops, increaed buffer fill before replay
    [ringbuf.c]
2025-02-03 main/wireless_gk.h: adjusted buffer offset to a more defensive value
2025-02-04 doc/Components.md: added tech reference for ESP32-C6
2025-02-05 main/wireless_gk.h: back to 8 bufs, offset 4
2025-02-06 main/wireless_gk.h: stats play, time1 removed
2025-02-06 main/wireless_gk.h: logging
2025-02-07 main/wireless_gk.h: changing Wifi channel
2025-02-11 main/wireless_gk.h: Wifi default channel
2025-02-11 main/wireless_gk.h: set NUM_RINGBUF_ELEMS to 32
2025-02-11 main/ringbuf.c: deactivated smoothing which caused errors. Needs a rewrite. This version works best so far. Latency 10.5 ms.
    [ringbuf.c]
2025-02-11 main/wireless_gk.h: set number of bufs to 64
2025-02-11 main/main.c: added temperature measurement
2025-02-12 main/wireless_gk.h: set offset to 3, trying sample rate 41667
2025-02-13 main/wireless_gk.h: buffer size 256 now
2025-02-13 README.md: current status updated
2025-02-19 doc/Components.md: changed ADC and DAC from AKM to TI; some minor changes
2025-02-19 doc/Filterdesign.md: changed ADC and DAC from AKM to TI; some number overhauls
2025-02-19 main/wireless_gk.h: 48 MHz / 31250 Hz experiment
